Vladislav909090/Rover-model/DXF/floor.dxf

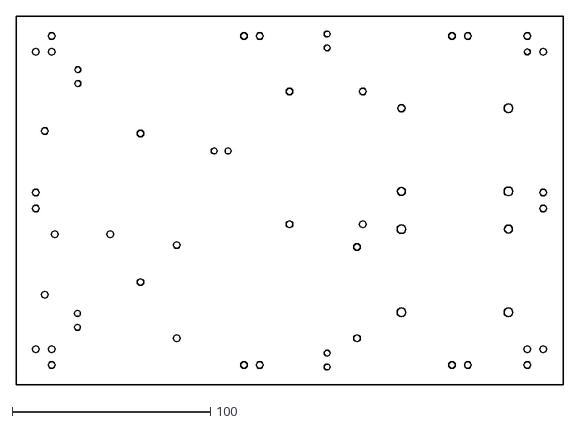
[picture p24: CAD file, 2021-04-16]
DXF/floor.dxf
276.0 x 186.0
