Vladislav909090/Rover-model/Rover_1_3_1.fcstd

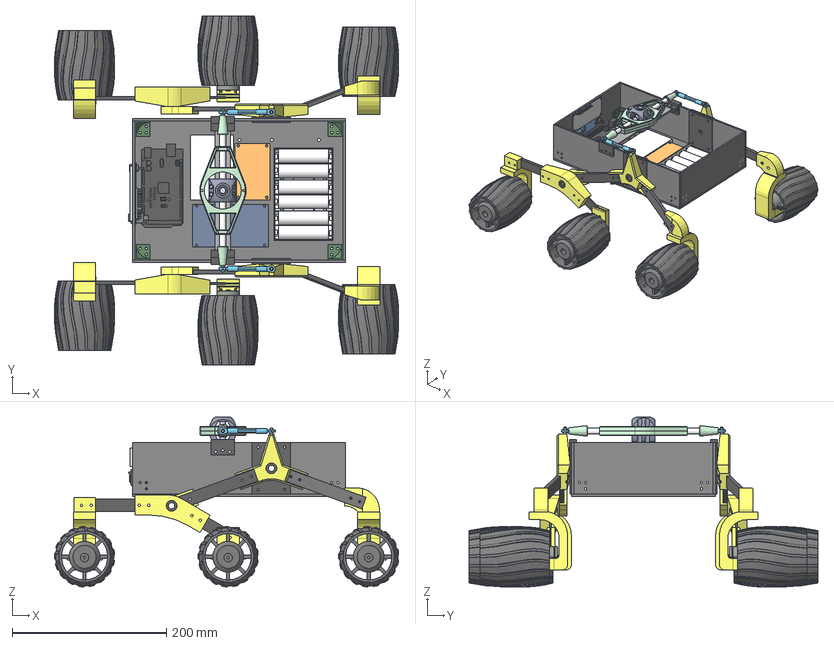
[picture p25: CAD file, 2021-02-22]
Rover_1_3_1.fcstd
446.0 x 452.0 x 220.1 mm
Индикатор заряда
Кнопка
Ардуина Мега
lcd 1602a
Цилиндр220
KSW3_2 R
KSW3_1 L
Макетка на первое время
KSW1 R
KSW4 R
KSW2 R
Marswheel1
Marswheel2
Marswheel3
Условно плата с EasyEDA
KPY R
Уголок004
Уголок003
Уголок1
Уголок002
KSW3_2 L
KSW3_1 R
KSW2 L
KSW4 L
KSW1 L
KPY L
Подшипник 8*14*4 1
Подшипник 8*14*4 2
Подшипник 8*14*4 3
Подшипник 8*14*4 4
Подшипник 8*14*4 005
Подшипник 8*14*4 007
Подшипник 8*14*4 006
Подшипник 8*14*4 008
MC1
MC2
MC3
MC4
MC5
MC6
Marswheel6
Marswheel5
Marswheel4
Extrude286 (Mirror #3)
Extrude245 (Mirror #6)
Extrude283 (Mirror #7)
Extrude284 (Mirror #8)
power plug
battery 3x
protection board
