Vladislav909090/Rover-model/STL/деталь опоры №3.1 левая.stl

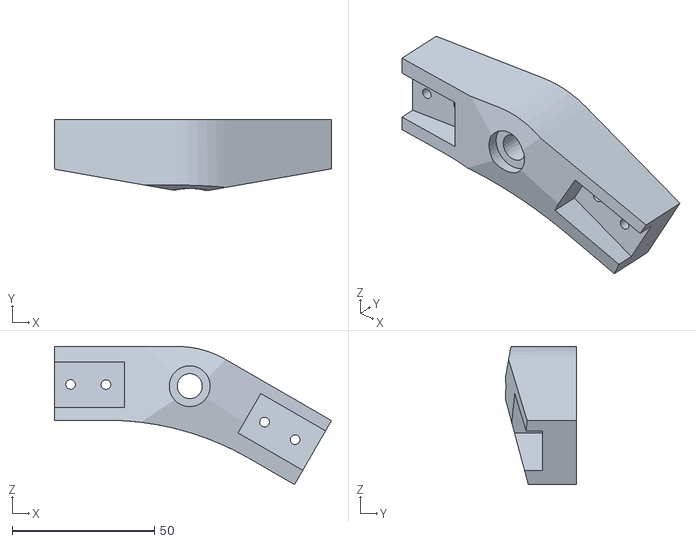
[picture p26: CAD file, 2021-03-20]
STL/деталь опоры №3.1 левая.stl
97.4 x 25.0 x 48.6
