Vladislav909090/Rover-model/DXF/wall -2.dxf

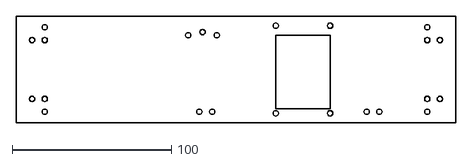
[picture p27: CAD file, 2021-04-16]
DXF/wall -2.dxf
276.0 x 67.0
