Vladislav909090/Rover-model/STL/внутренний шар.stl

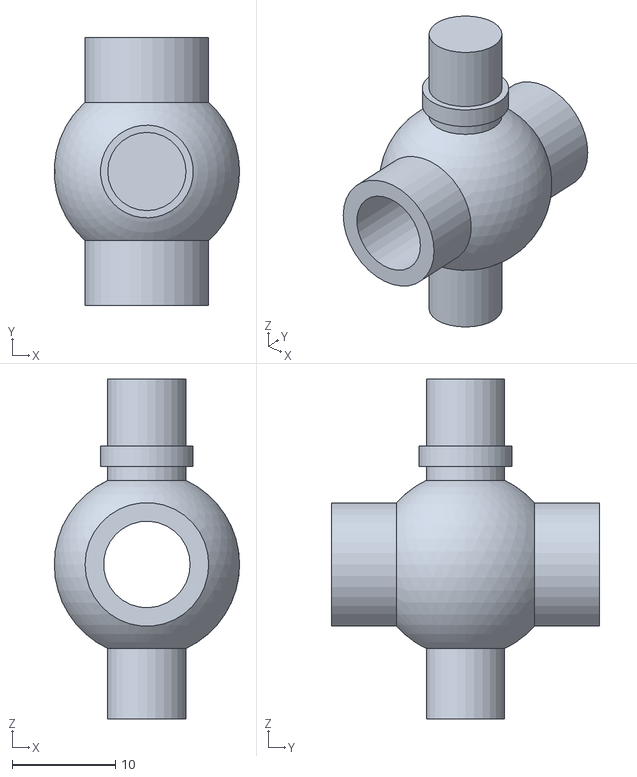
[picture p28: CAD file, 2021-03-20]
STL/внутренний шар.stl
18.0 x 26.0 x 33.0
