Vladislav909090/Rover-model/DXF/Leg 2.2 -2.dxf

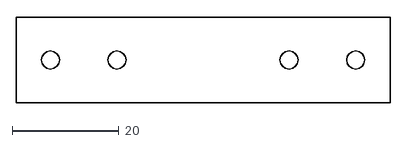
[picture p29: CAD file, 2021-04-16]
DXF/Leg 2.2 -2.dxf
70.0 x 16.0
