Vladislav909090/Rover-model/STL/угол (маленький).stl

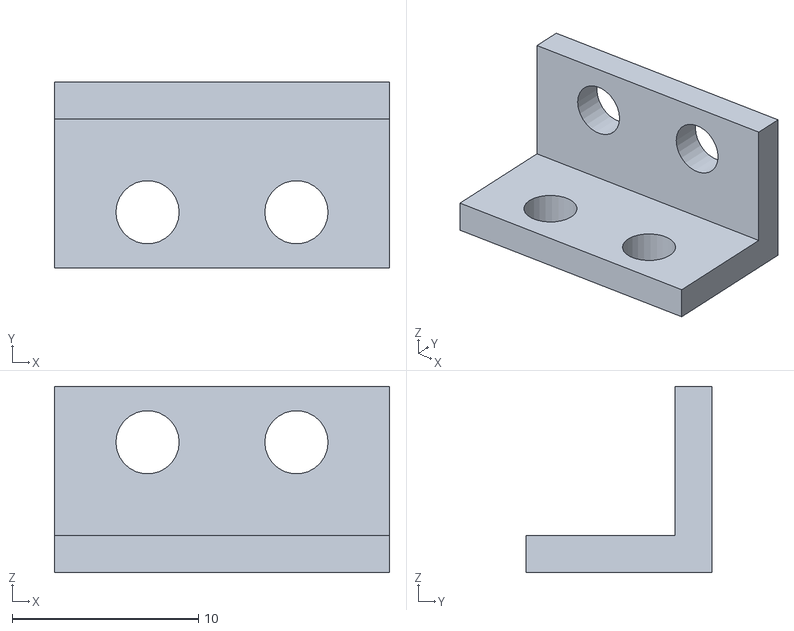
[picture p30: CAD file, 2021-03-20]
STL/угол (маленький).stl
18.0 x 10.0 x 10.0
