Vladislav909090/Rover-model/DXF/wall back.dxf

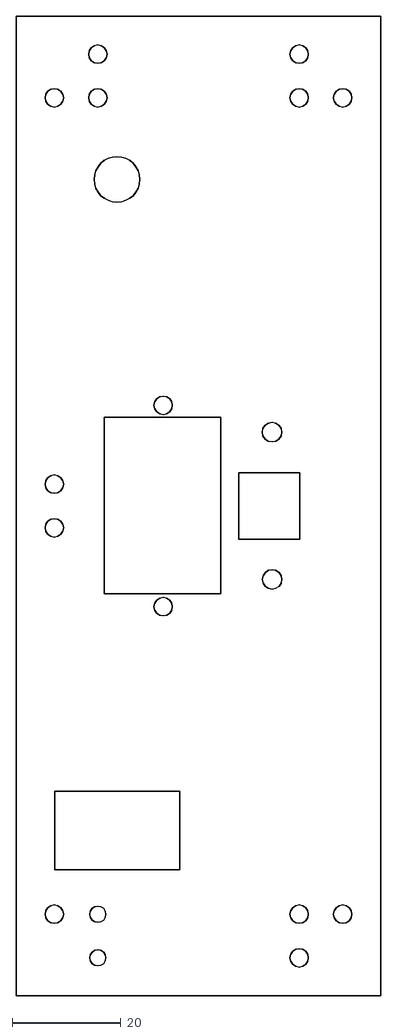
[picture p31: CAD file, 2021-04-16]
DXF/wall back.dxf
67.0 x 180.0
