Vladislav909090/Rover-model/STL/внутренняя пластина между СК и корпусом (2 шт).stl

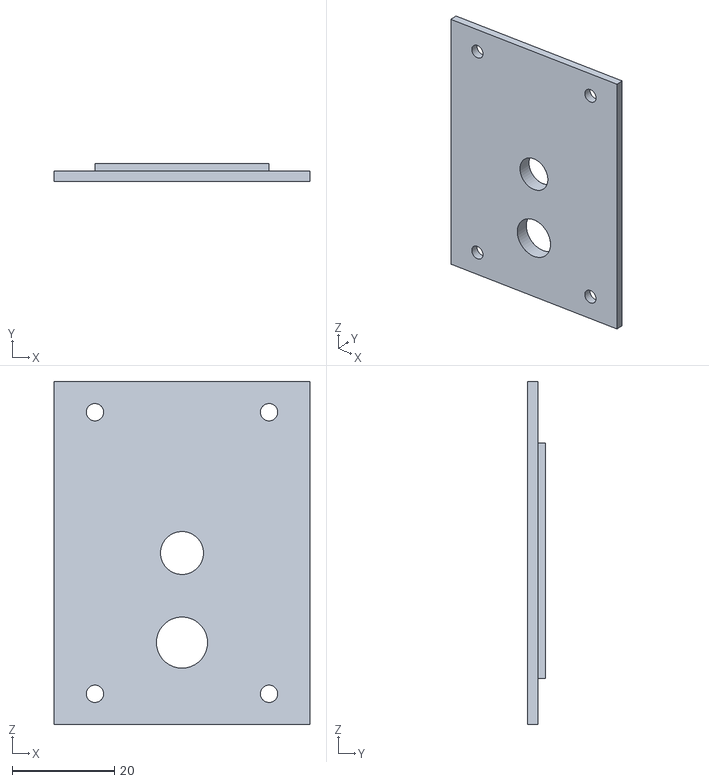
[picture p32: CAD file, 2021-03-20]
STL/внутренняя пластина между СК и корпусом (2 шт).stl
50.0 x 3.50 x 67.0
