Vladislav909090/Rover-model/DXF/Leg 2.1-2.dxf

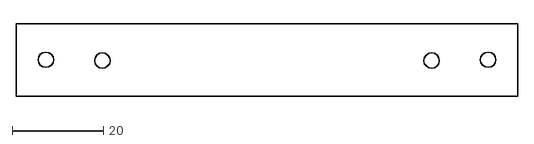
[picture p33: CAD file, 2021-04-16]
DXF/Leg 2.1-2.dxf
110.0 x 16.0
