Vladislav909090/Rover-model/STL/центральный шар низ.stl

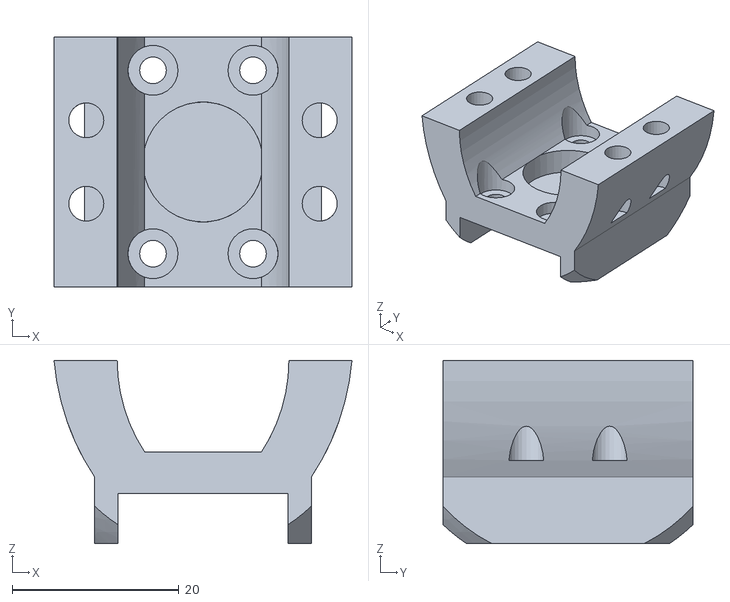
[picture p34: CAD file, 2021-03-20]
STL/центральный шар низ.stl
35.8 x 30.0 x 22.0
