Vladislav909090/Rover-model/STL/дугообразное усиление нижнее.stl

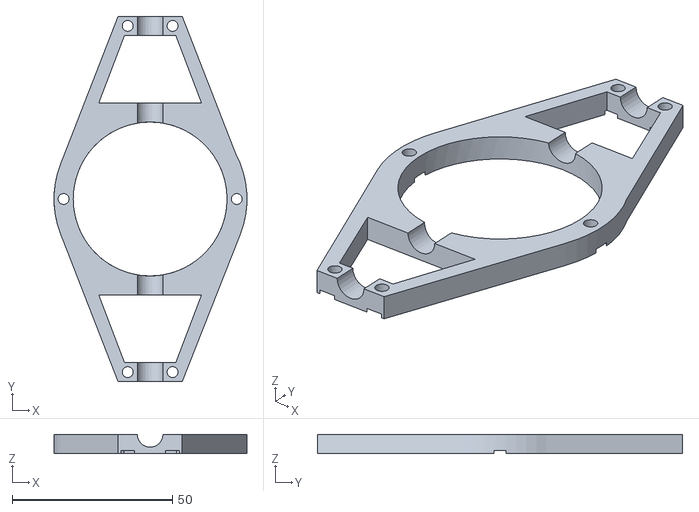
[picture p36: CAD file, 2021-03-20]
STL/дугообразное усиление нижнее.stl
60.2 x 114.0 x 6.00
