Vladislav909090/Rover-model/DXF/Leg 3 -2.dxf

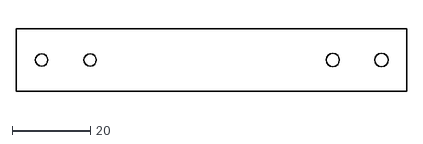
[picture p37: CAD file, 2021-04-16]
DXF/Leg 3 -2.dxf
100.0 x 16.0
