Vladislav909090/Rover-model/DXF/platform on top.dxf

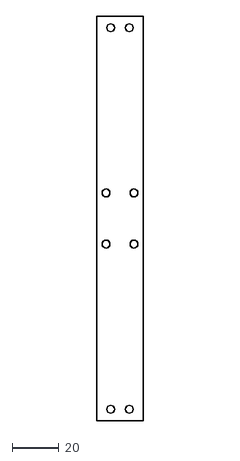
[picture p38: CAD file, 2021-04-16]
DXF/platform on top.dxf
20.0 x 174.0
