Vladislav909090/Rover-model/STL/звездочка для с-мы колес (правая).stl

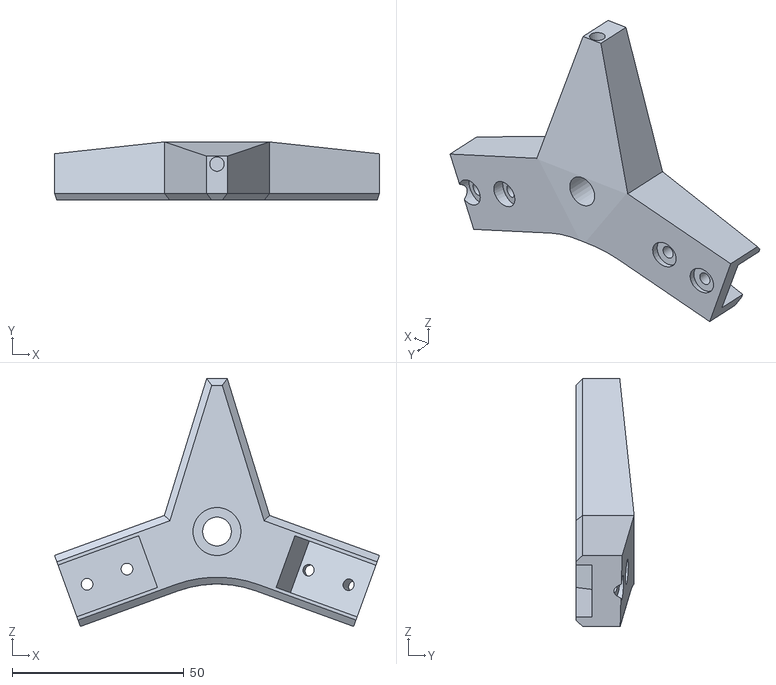
[picture p39: CAD file, 2021-03-20]
STL/звездочка для с-мы колес (правая).stl
94.5 x 17.0 x 72.1
