Vladislav909090/Rover-model/DXF/wall forward.dxf

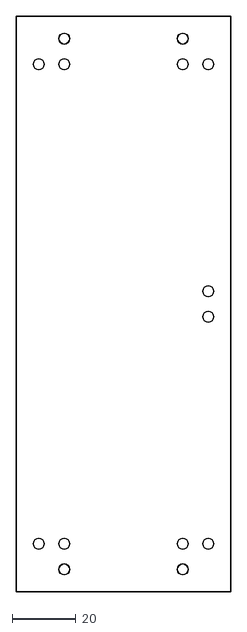
[picture p40: CAD file, 2021-04-16]
DXF/wall forward.dxf
67.0 x 180.0
