Vladislav909090/Rover-model/STL/центральный шар вверх.stl

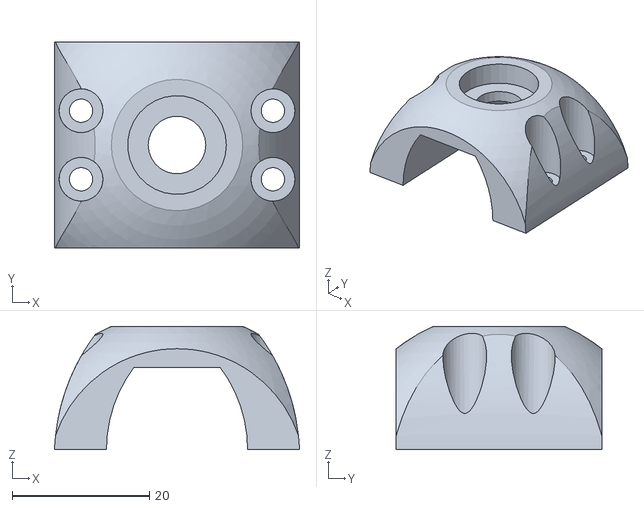
[picture p41: CAD file, 2021-03-20]
STL/центральный шар вверх.stl
35.8 x 30.0 x 18.0
