Vladislav909090/Rover-model/DXF/средняя нога (2 шт).dxf

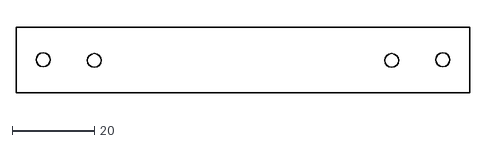
[picture p42: CAD file, 2021-03-20]
DXF/средняя нога (2 шт).dxf
110.0 x 16.0
