Vladislav909090/Rover-model/DXF/средняя нижняя нога (2 шт).dxf

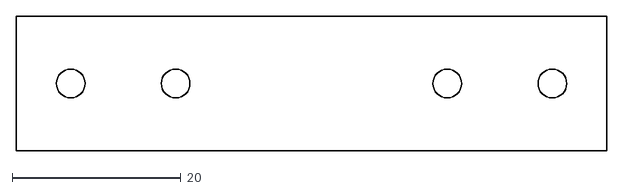
[picture p43: CAD file, 2021-03-20]
DXF/средняя нижняя нога (2 шт).dxf
70.0 x 16.0
