Vladislav909090/Rover-model/STL/деталь для крепежа пластины с корпусом (2 шт).stl

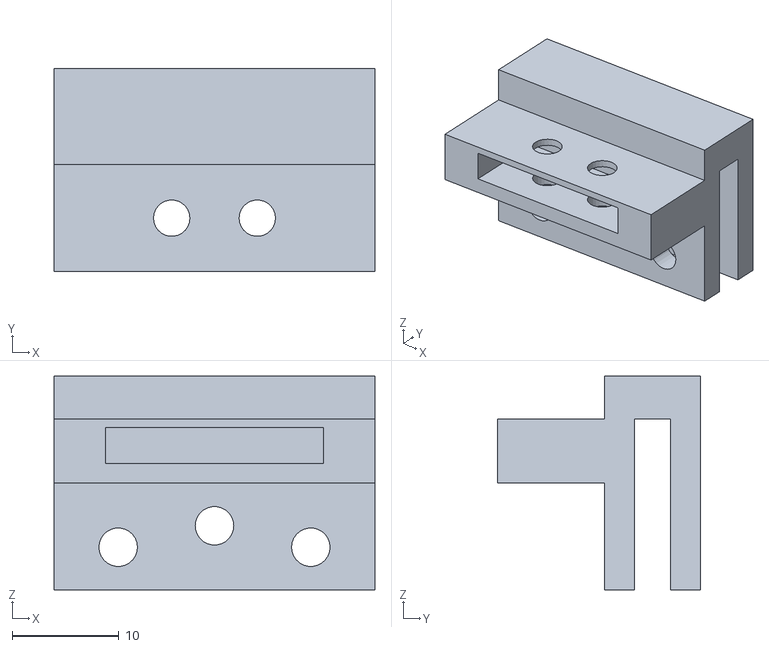
[picture p44: CAD file, 2021-03-20]
STL/деталь для крепежа пластины с корпусом (2 шт).stl
30.0 x 19.0 x 20.0
