Vladislav909090/Rover-model/DXF/задняя стенка.dxf

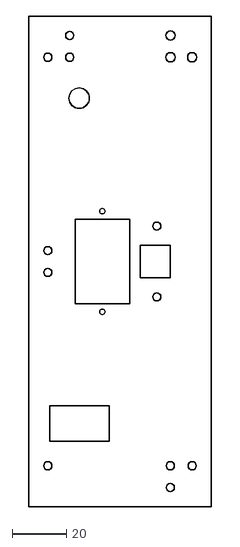
[picture p45: CAD file, 2021-03-20]
DXF/задняя стенка.dxf
67.0 x 180.0
