Vladislav909090/Rover-model/STL/угол (большой).stl

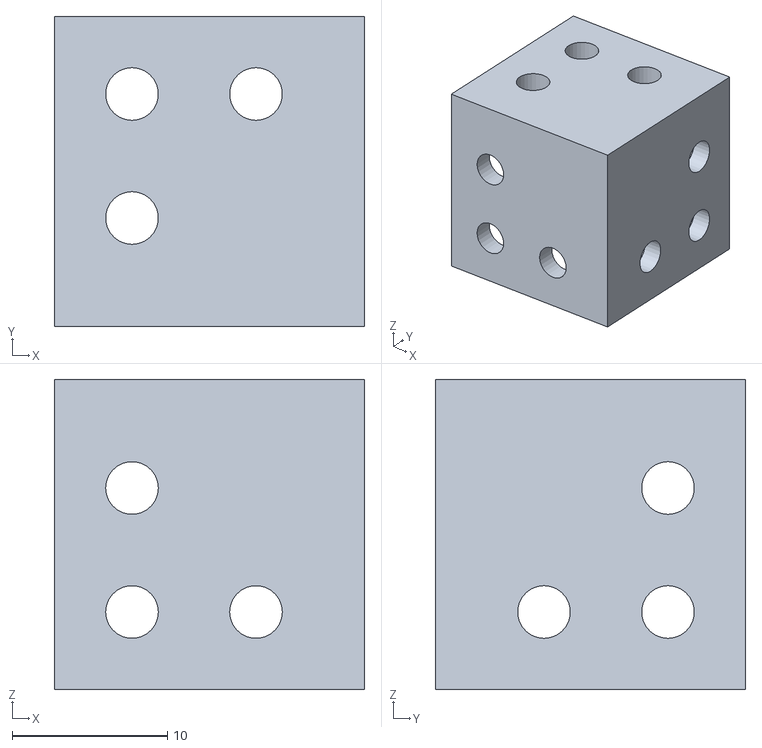
[picture p46: CAD file, 2021-03-20]
STL/угол (большой).stl
20.0 x 20.0 x 20.0
