Vladislav909090/Rover-model/DXF/боковая стенка (2 шт).dxf

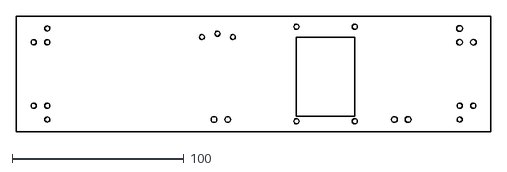
[picture p47: CAD file, 2021-03-20]
DXF/боковая стенка (2 шт).dxf
276.0 x 67.0
