Vladislav909090/Rover-model/STL/внешняя пластина между СК и корпусом (2 шт).stl

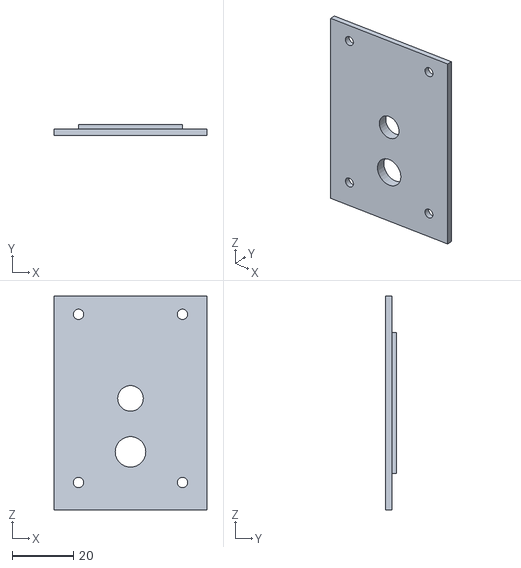
[picture p48: CAD file, 2021-03-20]
STL/внешняя пластина между СК и корпусом (2 шт).stl
50.0 x 3.50 x 70.0
