Vladislav909090/Rover-model/DXF/передняя нога (2 шт).dxf

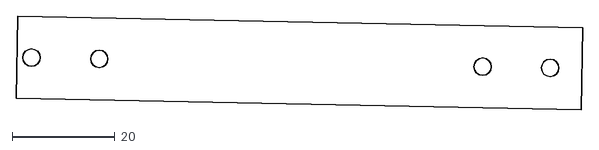
[picture p49: CAD file, 2021-03-20]
DXF/передняя нога (2 шт).dxf
110.3 x 18.2
