Vladislav909090/Rover-model/STL/конус (2 шт).stl

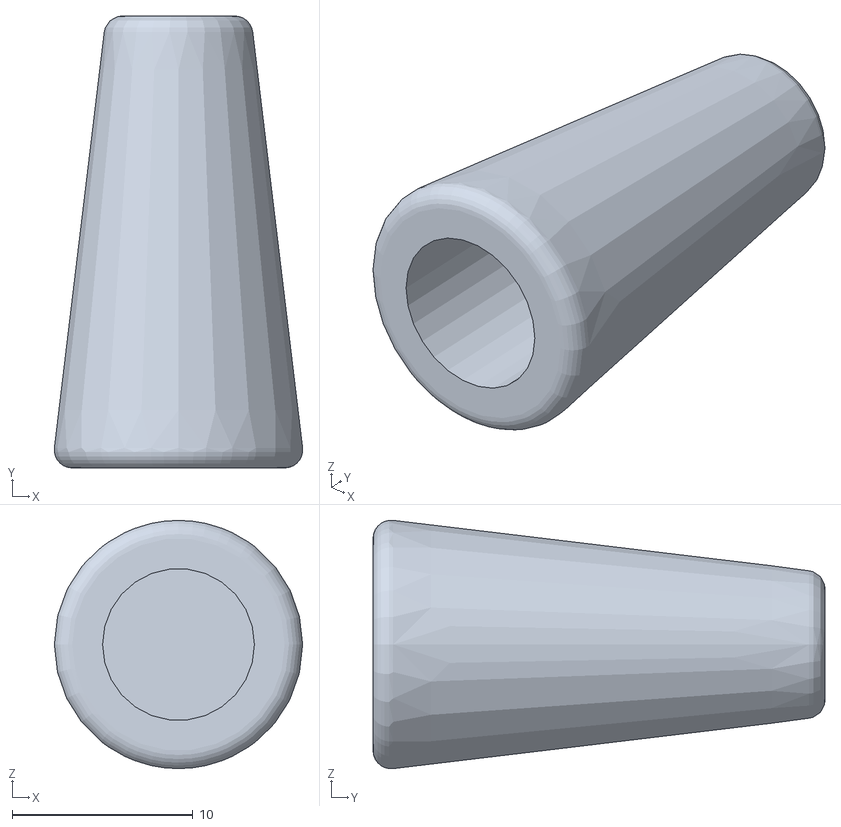
[picture p50: CAD file, 2021-03-20]
STL/конус (2 шт).stl
13.7 x 25.0 x 13.7
