Vladislav909090/Rover-model/DXF/задняя нога (2 шт).dxf

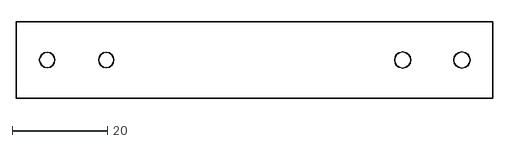
[picture p51: CAD file, 2021-03-20]
DXF/задняя нога (2 шт).dxf
100.0 x 16.0
