Vladislav909090/Rover-model/STL/дугообразное усиление верхнее.stl

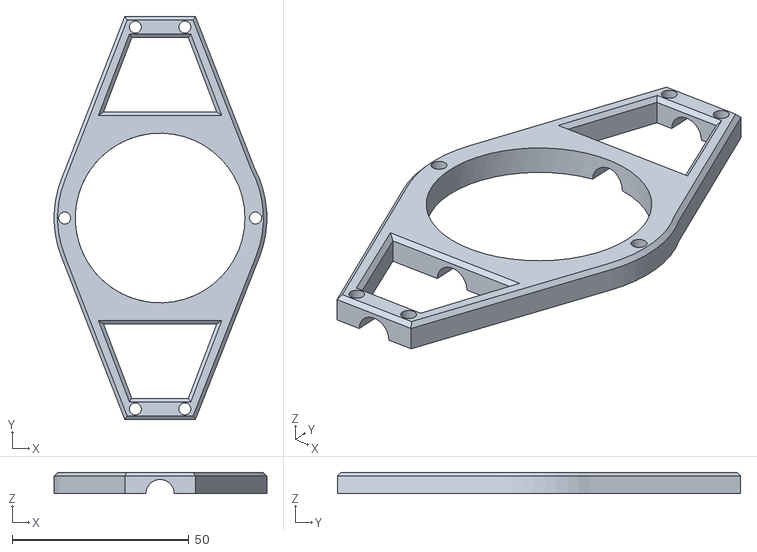
[picture p52: CAD file, 2021-03-20]
STL/дугообразное усиление верхнее.stl
60.1 x 114.0 x 6.00
