Vladislav909090/Rover-model/DXF/передняя стенка.dxf

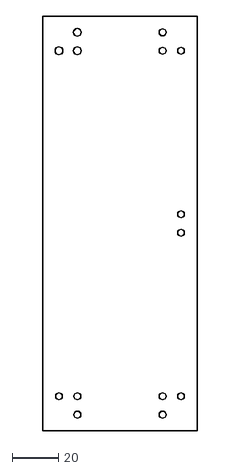
[picture p53: CAD file, 2021-03-20]
DXF/передняя стенка.dxf
67.0 x 180.0
