Vladislav909090/Rover-model/STL/колесо правое (3 шт).stl

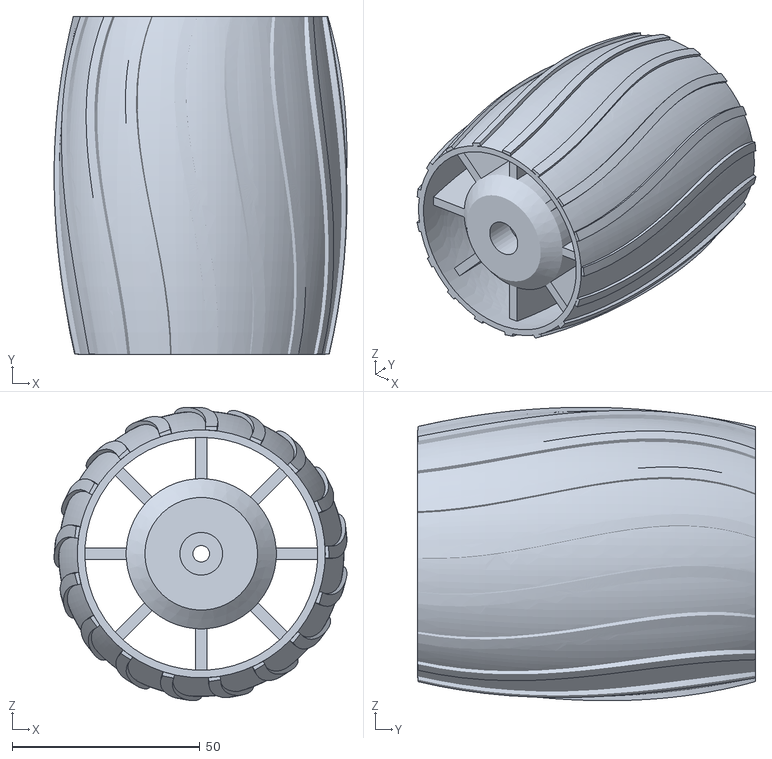
[picture p54: CAD file, 2021-03-02]
STL/колесо правое (3 шт).stl
78.0 x 90.0 x 78.1
