Vladislav909090/Rover-model/DXF/Дно.dxf

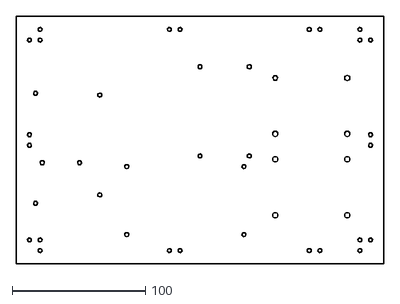
[picture p55: CAD file, 2021-02-24]
DXF/Дно.dxf
276.0 x 186.0
