Vladislav909090/Rover-model/DXF/тонкая пластина сверху (целиком).dxf

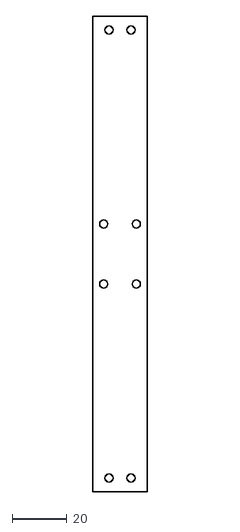
[picture p56: CAD file, 2021-02-24]
DXF/тонкая пластина сверху (целиком).dxf
20.0 x 174.0
