Vladislav909090/Rover-model/STL/деталь опоры №1 левая.stl

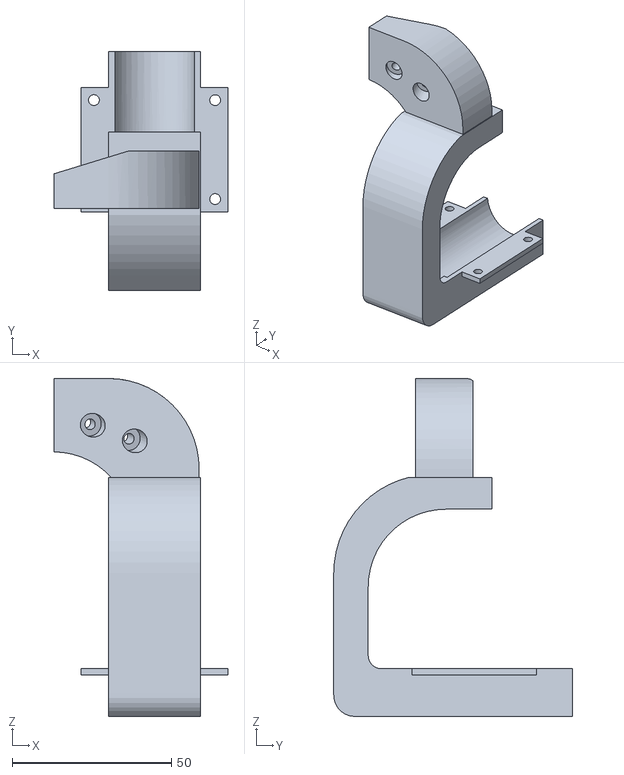
[picture p57: CAD file, 2021-03-01]
STL/деталь опоры №1 левая.stl
54.5 x 74.8 x 106.0
