Vladislav909090/Rover-model/STL/подложка под центральный шар.stl

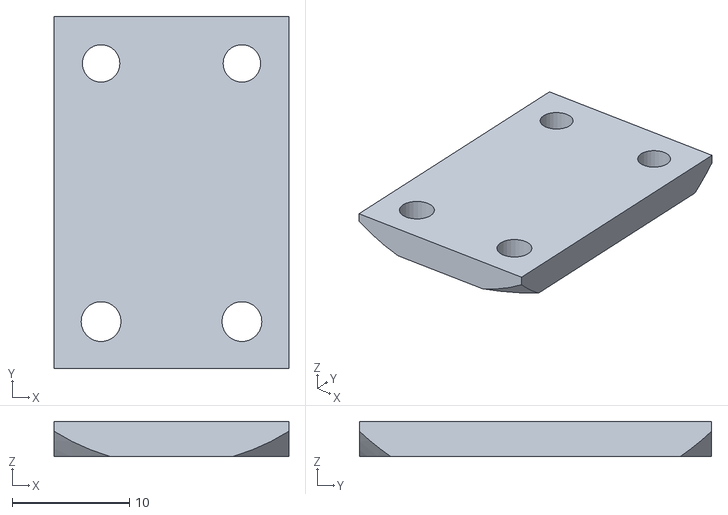
[picture p58: CAD file, 2021-02-24]
STL/подложка под центральный шар.stl
20.0 x 30.0 x 3.00
