Vladislav909090/Rover-model/STL/площадка сверху (2 шт).stl

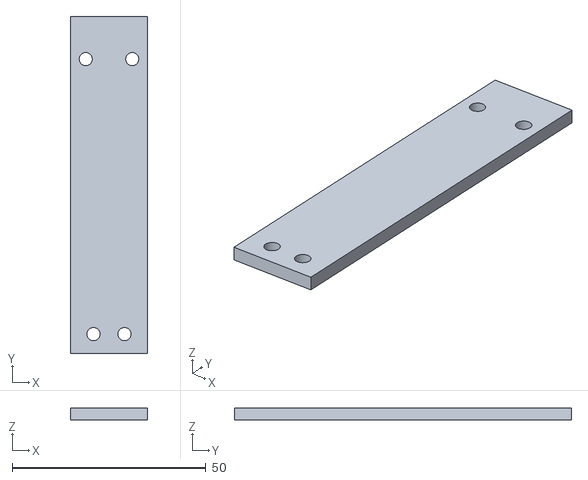
[picture p59: CAD file, 2021-02-22]
STL/площадка сверху (2 шт).stl
20.0 x 87.0 x 3.00
