Vladislav909090/Rover-model/STL/Крышка корпуса для платы защиты.stl

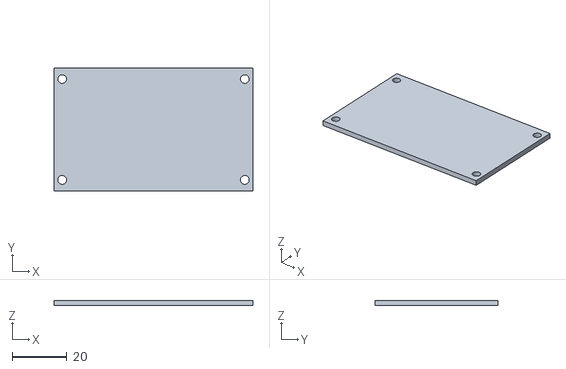
[picture p60: CAD file, 2021-02-21]
STL/Крышка корпуса для платы защиты.stl
73.0 x 45.0 x 2.00
