Vladislav909090/Rover-model/STL/Соединяюшая площадка (перед) (2 шт).stl

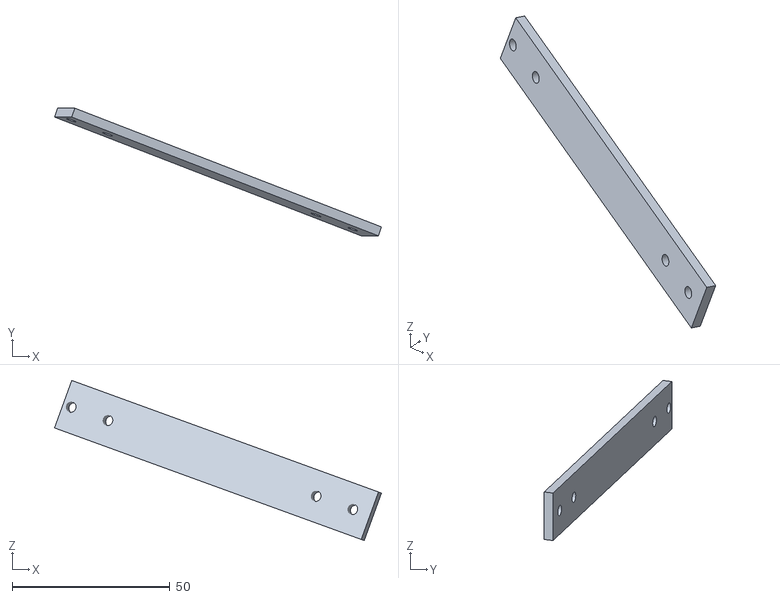
[picture p61: CAD file, 2021-02-21]
STL/Соединяюшая площадка (перед) (2 шт).stl
103.6 x 40.4 x 50.7
