Vladislav909090/Rover-model/STL/Соединяюшая площадка (перед) (2 шт) 5мм.stl

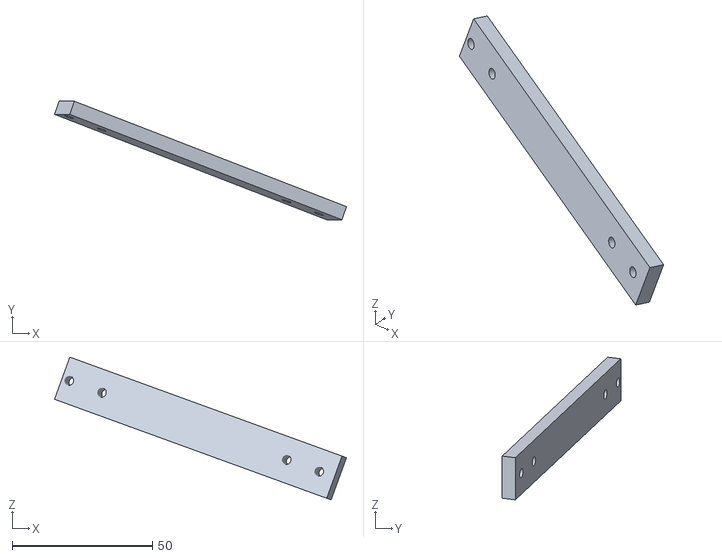
[picture p62: CAD file, 2021-02-21]
STL/Соединяюшая площадка (перед) (2 шт) 5мм.stl
104.2 x 42.3 x 51.0
