Vladislav909090/Rover-model/STL/деталь опоры №3.2 левая.stl

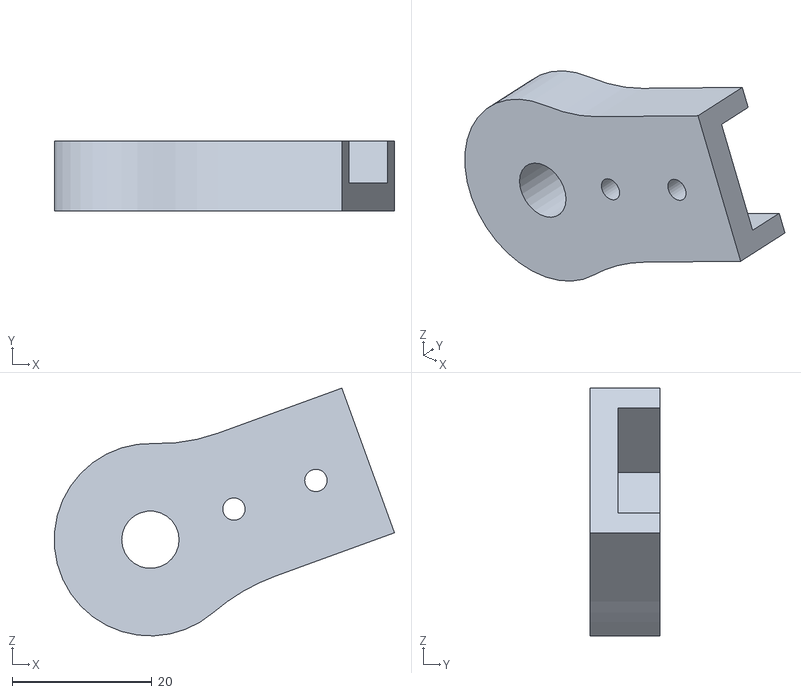
[picture p63: CAD file, 2021-02-21]
STL/деталь опоры №3.2 левая.stl
48.6 x 10.0 x 35.4
