Vladislav909090/Rover-model/STL/Соединяюшая площадка (низ) (2 шт).stl

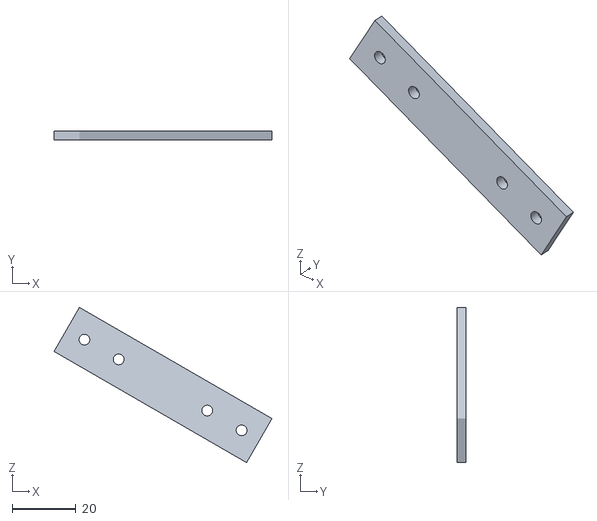
[picture p64: CAD file, 2021-02-21]
STL/Соединяюшая площадка (низ) (2 шт).stl
68.6 x 2.80 x 48.9
