Vladislav909090/Rover-model/STL/деталь опоры №4 правая.stl

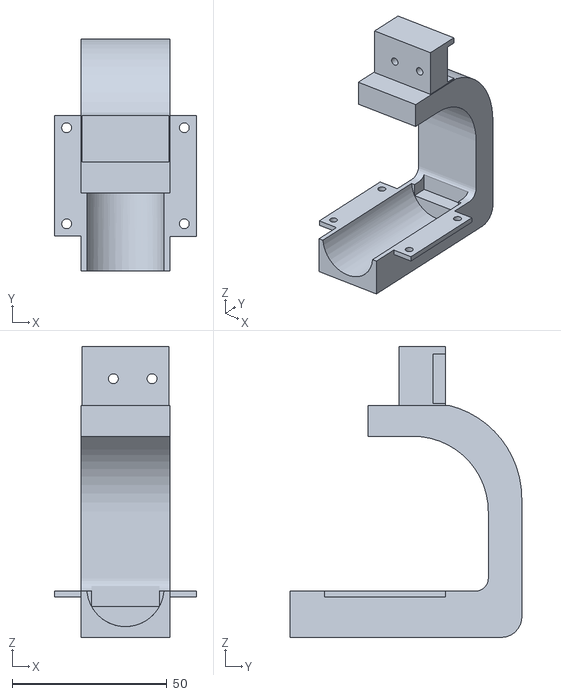
[picture p65: CAD file, 2021-02-21]
STL/деталь опоры №4 правая.stl
46.0 x 74.8 x 94.0
