Vladislav909090/Rover-model/STL/Соединяюшая площадка (центр) (2 шт) 5мм.stl

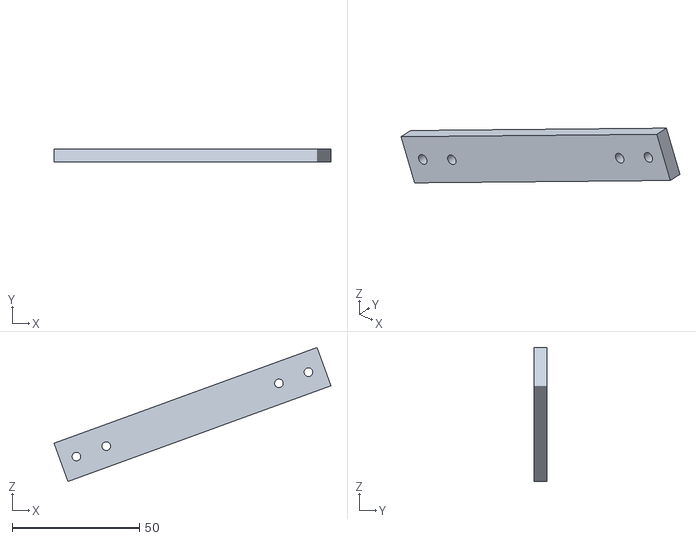
[picture p66: CAD file, 2021-02-21]
STL/Соединяюшая площадка (центр) (2 шт) 5мм.stl
108.8 x 5.00 x 52.7
