Vladislav909090/Rover-model/STL/Подставка под ардуину мега.stl

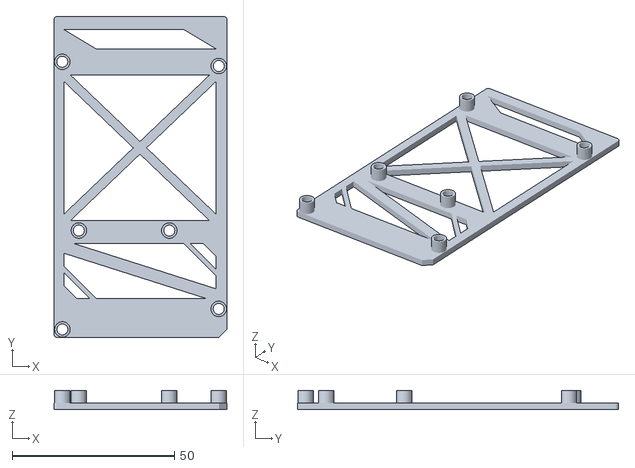
[picture p67: CAD file, 2021-02-21]
STL/Подставка под ардуину мега.stl
53.4 x 99.1 x 6.00
