Vladislav909090/Rover-model/STL/деталь опоры №2 правая.stl

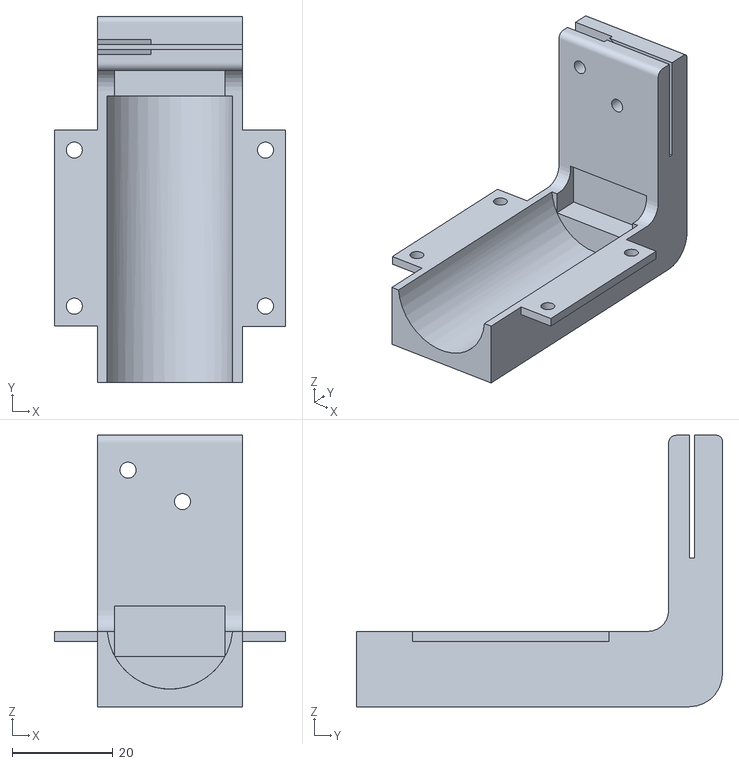
[picture p68: CAD file, 2021-02-21]
STL/деталь опоры №2 правая.stl
46.0 x 72.8 x 54.0
