Vladislav909090/Rover-model/STL/деталь опоры №3.2 правая.stl

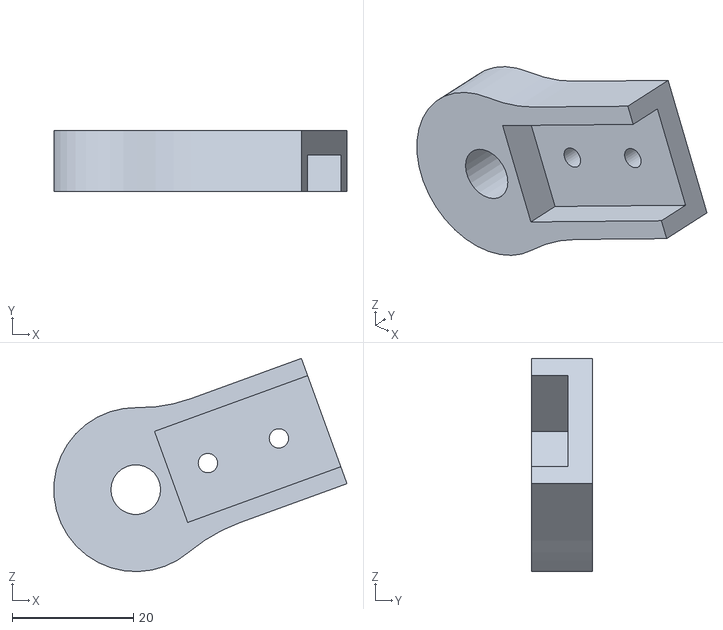
[picture p69: CAD file, 2021-02-21]
STL/деталь опоры №3.2 правая.stl
48.4 x 10.0 x 35.2
