Vladislav909090/Rover-model/STL/крепление мотора (нужно 6 шт).stl

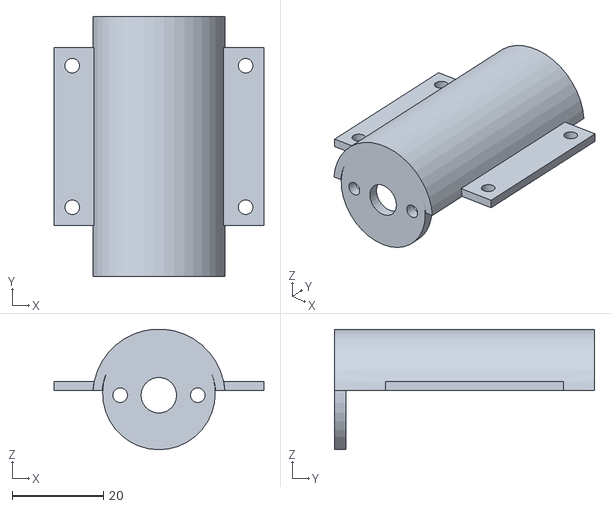
[picture p70: CAD file, 2021-02-21]
STL/крепление мотора (нужно 6 шт).stl
46.0 x 57.0 x 26.4
