Vladislav909090/Rover-model/STL/Соединяюшая площадка (зад) (2 шт)5мм.stl

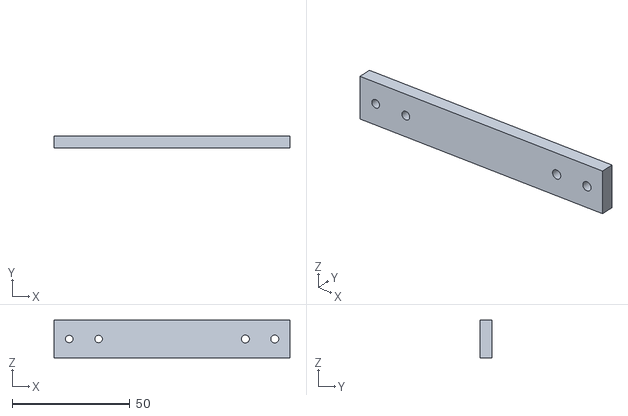
[picture p71: CAD file, 2021-02-21]
STL/Соединяюшая площадка (зад) (2 шт)5мм.stl
100.0 x 5.00 x 16.0
