Vladislav909090/Rover-model/STL/Корпус для платы защиты.stl

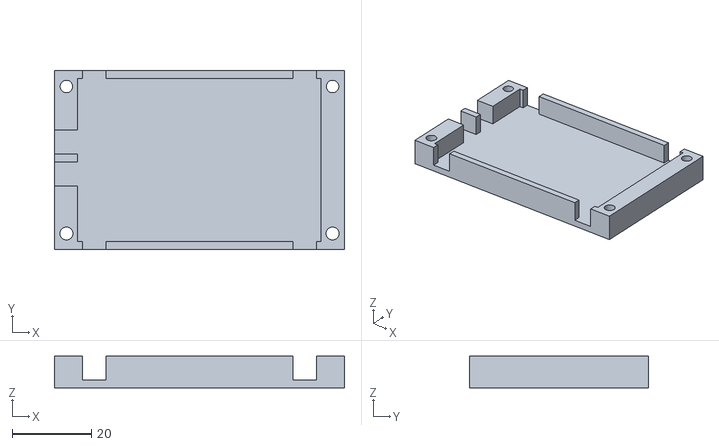
[picture p72: CAD file, 2021-02-21]
STL/Корпус для платы защиты.stl
73.0 x 45.0 x 8.00
