Vladislav909090/Rover-model/STL/Соединяюшая площадка (зад) (2 шт).stl

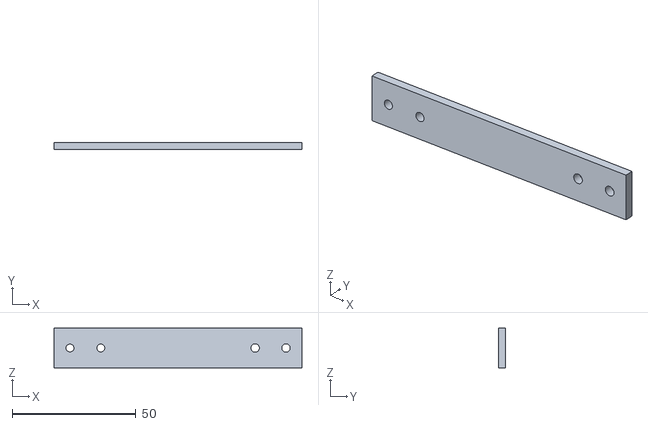
[picture p73: CAD file, 2021-02-21]
STL/Соединяюшая площадка (зад) (2 шт).stl
100.0 x 3.00 x 16.0
