Vladislav909090/Rover-model/STL/Соединяюшая площадка (центр) (2 шт).stl

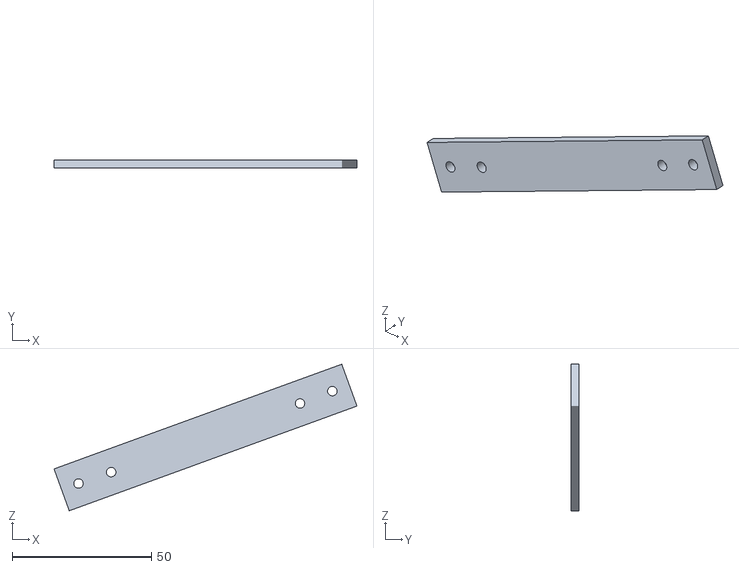
[picture p74: CAD file, 2021-02-21]
STL/Соединяюшая площадка (центр) (2 шт).stl
108.8 x 3.00 x 52.7
