Vladislav909090/Rover-model/(list of files, cad)

Other CAD files:
STL/деталь опоры №3.1 правая.stl
STL/звездочка для с-мы колес (левая).stl
STL/колесо левое (3 шт).stl
STL/деталь опоры №1 правая.stl
STL/деталь опоры №4 левая.stl
STL/деталь опоры №2 левая.stl
