Vladislav909090/Rover-model/(threads)

Thread 4 (2021-03-01):

"Спицы" колеса не соединены с внутренним цилиндром

sadr0b0t, 2021-03-01:
Внутренний цилиндр (в который вставляется мотор) держится на спицах, судя по всему, только благодаря погрешности печати. Нужно спицы утопить в этот цилиндр, чтобы они печатались как монолит

Closed 2021-03-20.

Thread 6 (2021-03-13):

Микроскопическая щель между рисунком проектора и колесом

sadr0b0t, 2021-03-13:
Заметил на одом из скринов под удачным ракурсом, но поймать этот ракурс довольно сложно. И потом Игорь показал как подготовилось задание для печати - это видно по дорожке пластика, уже точно.

На печати на фильном результате не отражается - всё сливается, но это помарка, которую нужно исправить. Плюс, возможно, из-за этого задание на печать формируется не так оптимально

Thread 7 (2021-03-20):

Напечатать исправленные детали

Vladislav909090, 2021-03-20:
https://github.com/Vladislav909090/Rover-model/blob/m..

https://github.com/Vladislav909090/Rover-model/blob/m..

https://github.com/Vladislav909090/Rover-model/blob/m..

https://github.com/Vladislav909090/Rover-model/blob/m..№3.1%20левая.stl

https://github.com/Vladislav909090/Rover-model/blob/m..№3.1%20правая.stl

https://github.com/Vladislav909090/Rover-model/blob/m..

https://github.com/Vladislav909090/Rover-model/blob/m..

https://github.com/Vladislav909090/Rover-model/blob/m.. 6 шт

https://github.com/Vladislav909090/Rover-model/blob/m.. 4 шт

https://github.com/Vladislav909090/Rover-model/blob/m..

https://github.com/Vladislav909090/Rover-model/blob/m..
