Vladislav909090/Rover-model/(commit log)

2021-02-17 добавили модель ровера: версия 1.2.2
2021-02-21 Начал формировать группы объектов, исправлять ошибки
    [Rover_1_3_0.fcstd]
2021-02-21 добавил STL файлы
    [Деталь средняя исправленная левая.stl, Деталь средняя исправленная правая.stl, Корпус для платы защиты.stl, Крышка корпуса для платы защиты.stl, Подставка под ардуину мега.stl, Соединяюшая площадка (зад) (2 шт).stl, Соединяюшая площадка (зад) (2 шт)5мм.stl, Соединяюшая площадка (низ) (2 шт).stl]
2021-02-22 Новая версия ровера. Исправлена крестовая часть, начал делать вырезы под всякие штекеры
    [Rover_1_3_0.fcstd, Rover_1_3_1.fcstd]
2021-02-22 Все объекты получили свои названия; появились вырезы под штекеры, кнопку, индикатор питания; исправлены отверстия в боковых площадках корпуса ровера (кроме нижней грани); созданы маленькие уголки для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
    [деталь для крепежа пластины с корпусом (2 шт).stl, дугообразное усиление верхнее.stl, дугообразное усиление нижнее.stl, звездочка для с-мы колес (левая).stl, звездочка для с-мы колес (правая).stl, колесо левое [испр] (3 шт).stl, колесо правое [испр] (3 шт).stl, площадка сверху (2 шт).stl]
2021-02-23 Исправлены названия некоторых STL файлов; исправлена нижняя площадка в корпусе (сделаны все отверстия под компоненты и уголки)
    [колесо левое (3 шт).stl, колесо правое (3 шт).stl]
2021-02-24 Добавил недостающие файлы stl, убрал лишние; исправил боковые панели между корпусом и СК; добавил все dxf файлы
    [Дно.dxf, боковая стенка (2 шт).dxf, внешняя пластина между СК и корпусом (2 шт).stl, внутренняя пластина между СК и корпусом (2 шт).stl, деталь опоры №3.1 левая.stl, деталь опоры №3.1 правая.stl, задняя нога (2 шт).dxf, задняя стенка.dxf]
2021-03-01 Исправил колесо: -имеет толщину 2мм; - толщина одинаковая на всем протяжении колеса; - вырез под отверстия сбоку колеса теперь по центру:)). Исправлены немного отверстия под винты и шайбы.
    [деталь опоры №1 левая.stl, деталь опоры №1 правая.stl, колесо левое (3 шт).stl, колесо правое (3 шт).stl]
2021-03-02 Изменил зазор между спицами и внутренним цилиндром колеса; исправил соответствующие STL
    [боковые крепления для центральной опоры (нужно 2 шт).stl, колесо левое (3 шт).stl, колесо правое (3 шт).stl, шар внутри центрального шара.stl]
2021-03-20 исправил dxf файлы, тк были неправильно созданы; исправил летали с подшипниками; мелкие исправления
    [боковая стенка (2 шт).dxf, внешняя пластина между СК и корпусом (2 шт).stl, внутренний шар.stl, внутренняя пластина между СК и корпусом (2 шт).stl, деталь для крепежа пластины с корпусом (2 шт).stl, деталь опоры №3.1 левая.stl, деталь опоры №3.1 правая.stl, дугообразное усиление верхнее.stl]
2021-04-16 Некоторые изменения в модели; доработаны dxf и stl части
    [Leg 1 -2.dxf, Leg 2.1-2.dxf, Leg 2.2 -2.dxf, Leg 3 -2.dxf, floor.dxf, platform on top.dxf, wall -2.dxf, wall back.dxf]
2021-05-03 описание проекта
